mdub555/pandoras-music-box/wiring_diagram.pdf

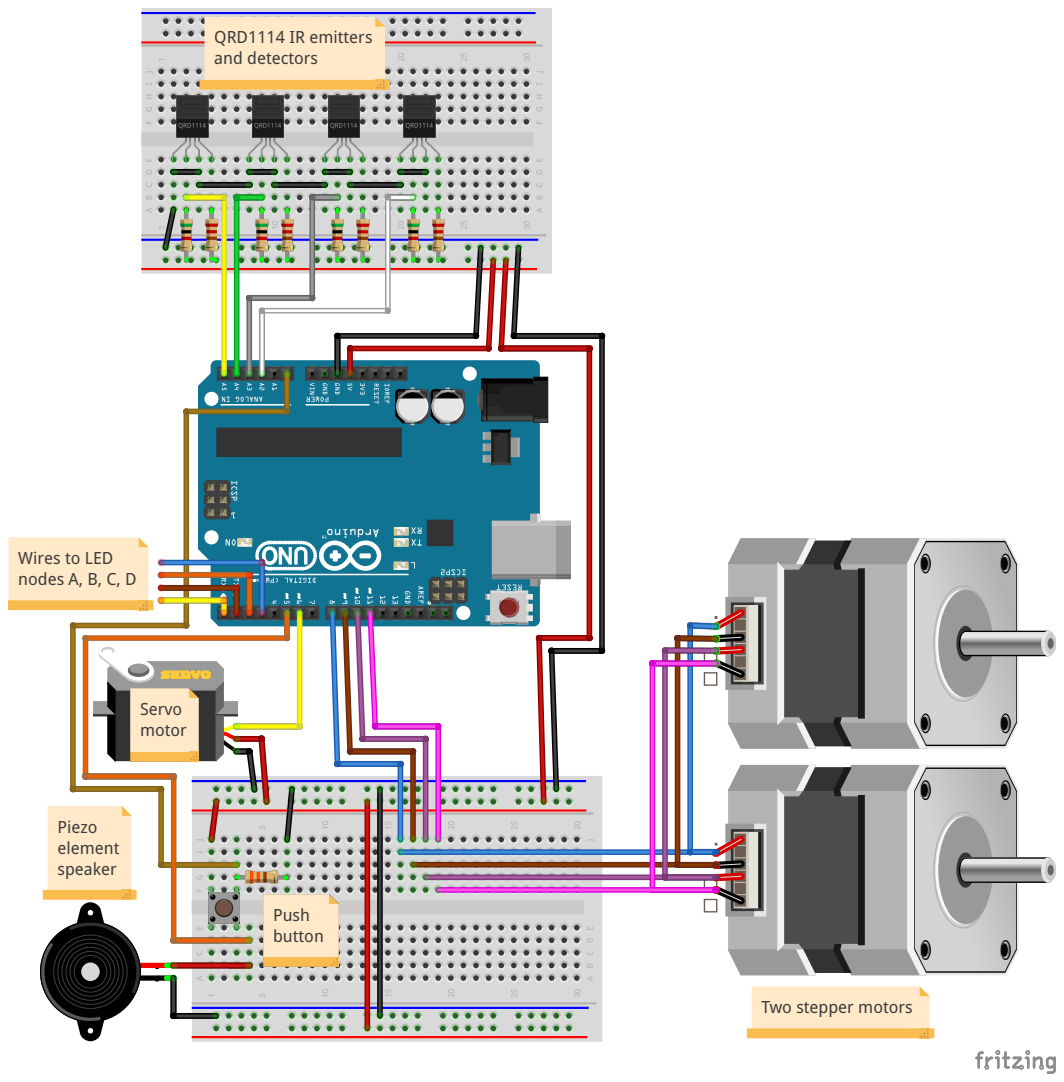
[picture p5: page 1]
Piezo element speaker; Push button; Servo motor; QRD1114 IR emitters and detectors

Wires to LED
nodes A, B, C, D

Two stepper motors
