mdub555/pandoras-music-box/(list of files, drawings)

Other design files:
wiring_diagram.fzz
